psas/lv3.1-avionics/README.md

# lv3.1-avionics
Avionics for the LV3.1 rocket
