psas/lv3.1-avionics/CameraBoard/eagle/CameraBoardRev1.0.jpg

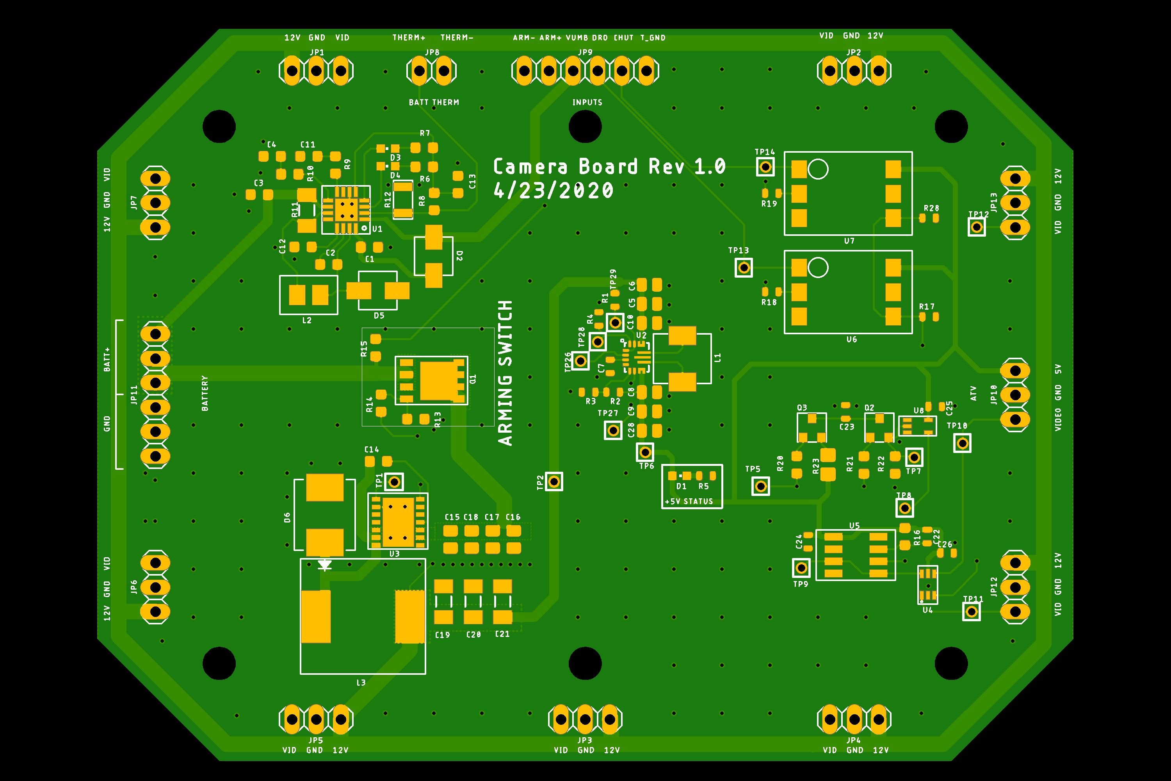
CameraBoard/eagle/CameraBoardRev1.0.jpg
