psas/lv3.1-avionics/CameraBoard/eagle/cameraMasterBoard.DXF

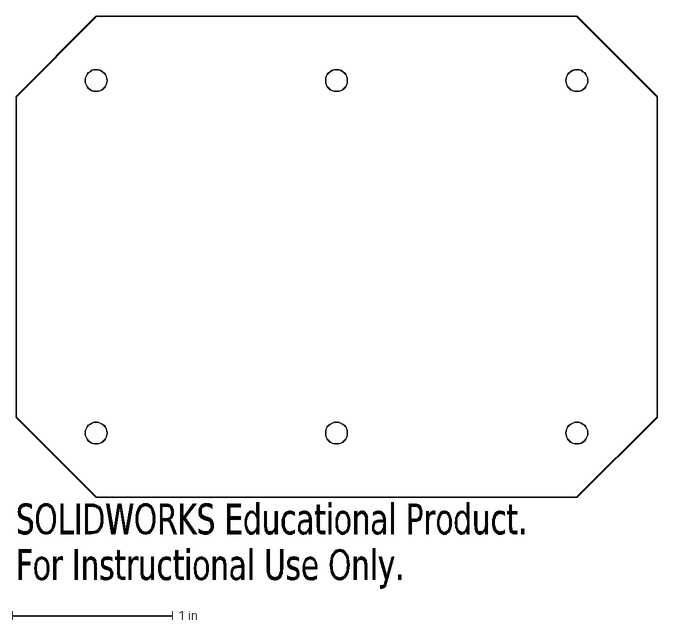
[picture p2: CAD file, 2020-04-24]
CameraBoard/eagle/cameraMasterBoard.DXF
SOLIDWORKS Educational Product.
For Instructional Use Only.
