psas/lv3.1-avionics/CameraBoard/kicad/CameraBoard.kicad_pcb

## KiCad design CameraBoard/kicad/CameraBoard.kicad_pcb (2026-08-20)

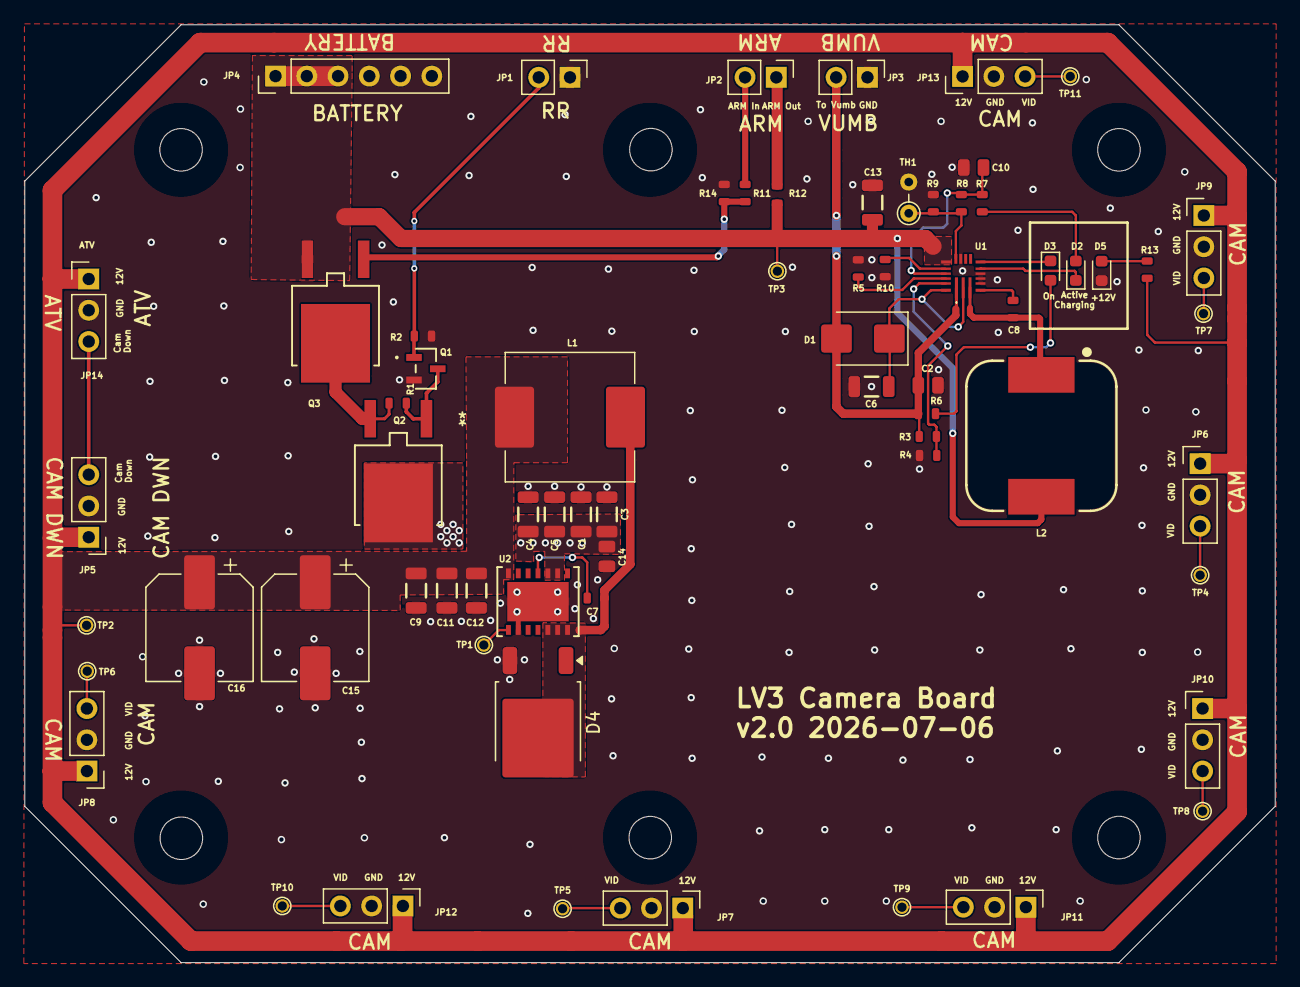
[picture p3: board CameraBoard.kicad_pcb from above]

Board: 2 copper layers, 101.6 x 76.2 mm, 68 parts (0 on the bottom side), 36 nets.

Parts:
C1, C3, C4, C5, C9, C11, C12, C13: 10u; 1206-C
C2, C10, C14: 1u; 0805-C-NOSILK
C6: 2.2u; 1206-C
C7: 10n; 0603-C-NOSILK
C8: 100n; 0603-C-NOSILK
C15, C16: 100u; CP_Elec_8x10.5
D1: B240; D_SMB
D2, D3: AMB; LED_0603_1608Metric
D4: MBRD835; TO-252-2
D5: GRN; LED_0603_1608Metric
JP1, JP2, JP3: PinHeader_1x02_P2.54mm_Vertical
JP4: PINHD-1X6; PinHeader_1x06_P2.54mm_Vertical
JP5, JP6, JP7, JP8, JP9, JP10, JP11, JP12, JP13, JP14: PINHD-1X3; PinHeader_1x03_P2.54mm_Vertical
L1: 22u; L_Vishay_IHLP-4040
L2: 10u; WE-PD_1260
Q1: DMG3404L-7; DMG3404L_DIO
Q2, Q3: AOD4185; TO252_AOS-M
R1, R2, R4, R6, R13: 10k; 0603-C-NOSILK
R3: 133k; 0603-C-NOSILK
R5: 33k; 0603-C-NOSILK
R7: 2k; 0603-C-NOSILK
R8: 2.26k; 0603-C-NOSILK
R9: 6.98k; 0603-C-NOSILK
R10: 38.3k; 0603-C-NOSILK
R11, R12: 1k; 0603-C-NOSILK
R14: 150k; 0603-C-NOSILK
TH1: 10k; R_Axial_DIN0204_L3.6mm_D1.6mm_P2.54mm_Vertical
TP1, TP2, TP3, TP4, TP5, TP6, TP7, TP8, TP9, TP10, TP11: Test-Point; TestPoint-0.75mm-th
U1: MP2659GQ-0000-Z; MP2659GQ0000Z
U2: LM2678SD-ADJ/NOPB; SRC14A

Connections:
+12V: C9.1, C11.1, C12.1, C15.1, C16.1, JP5.1, JP6.1, JP7.1, JP8.1, JP9.1, JP10.1, JP11.1, JP12.1, JP13.1, JP14.1, L1.2, R13.2, TP2.1 (1_1), U2.7 (FB)
/ARM-IN: JP2.2, R11.1
/ARM-OUT: JP2.1, R12.1
/BATT+: C13.1, JP4.1, JP4.2, JP4.3, L2.2, Q3.3 (S), R12.2, TP3.1 (1_1), U1.14 (BATT)
/CAM_DOWN: JP5.3, JP14.3
/VUMB: C2.1, D1.2 (A), JP3.2, R3.2, R6.1, U1.1 (IN)
GND: C1.2, C2.2, C3.2, C4.2, C5.2, C6.1, C9.2, C10.2, C11.2, C12.2, C13.2, C14.2, C15.2, C16.2, D4.3 (A), D5.1 (K), JP1.1, JP3.1, JP4.4, JP4.5, JP4.6, JP5.2, JP6.2, JP7.2, JP8.2, JP9.2, JP10.2, JP11.2, JP12.2, JP13.2, JP14.2, Q1.2 (S), R2.2, R4.1, R5.1, R9.2, R10.2, R14.2, TH1.2, U1.5 (PGND), U1.6 (PGND), U1.7 (PGND), U1.12 (AGND), U2.9 (GND), U2.15 (GND)
unnamed: C6.2, D1.1 (K), U1.2 (PMID), U1.19 (PMID_S)
unnamed: D2.2 (A), R6.2
unnamed: D2.1 (K), U1.9 (~ACOK)
unnamed: D3.2 (A), R7.2
unnamed: D3.1 (K), U1.8 (~STAT)
unnamed: C7.1, D4.2 (K), L1.1, U2.12 (SW), U2.13 (SW), U2.14 (SW)
unnamed: D5.2 (A), R13.1
unnamed: JP1.2, Q1.1 (G), R2.1
unnamed: JP6.3, TP4.1 (1_1)
unnamed: JP7.3, TP5.1 (1_1)
unnamed: JP8.3, TP6.1 (1_1)
unnamed: JP9.3, TP7.1 (1_1)
unnamed: JP10.3, TP8.1 (1_1)
unnamed: JP11.3, TP9.1 (1_1)
unnamed: JP12.3, TP10.1 (1_1)
unnamed: JP13.3, TP11.1 (1_1)
unnamed: Q1.3 (D), Q2.1 (G), R1.2
unnamed: C1.1, C3.1, C4.1, C5.1, C14.1, Q2.2 (D), U2.2 (Vin), U2.3 (Vin)
unnamed: Q3.1 (G), R11.2, R14.1
unnamed: C8.1, U1.4 (BST)
unnamed: R5.2, U1.17 (ILIM)
unnamed: R10.1, U1.15 (ISET)
unnamed: R8.2, R9.1, TH1.1, U1.13 (NTC)
unnamed: C8.2, L2.1, U1.3 (SW)
unnamed: R3.1, R4.2, U1.18 (VDPM)
unnamed: C7.2, U2.4 (BOOST)
unnamed: TP1.1 (1_1), U2.8 (ON)
VBATT: Q2.3 (S), Q3.2 (D), R1.1
VCC: C10.1, R7.1, R8.1, U1.16 (VCC)
