psas/lv3.1-avionics/CameraBoard/eagle/CameraBoard.brd

## EAGLE design CameraBoard/eagle/CameraBoard.brd (2020-07-20)

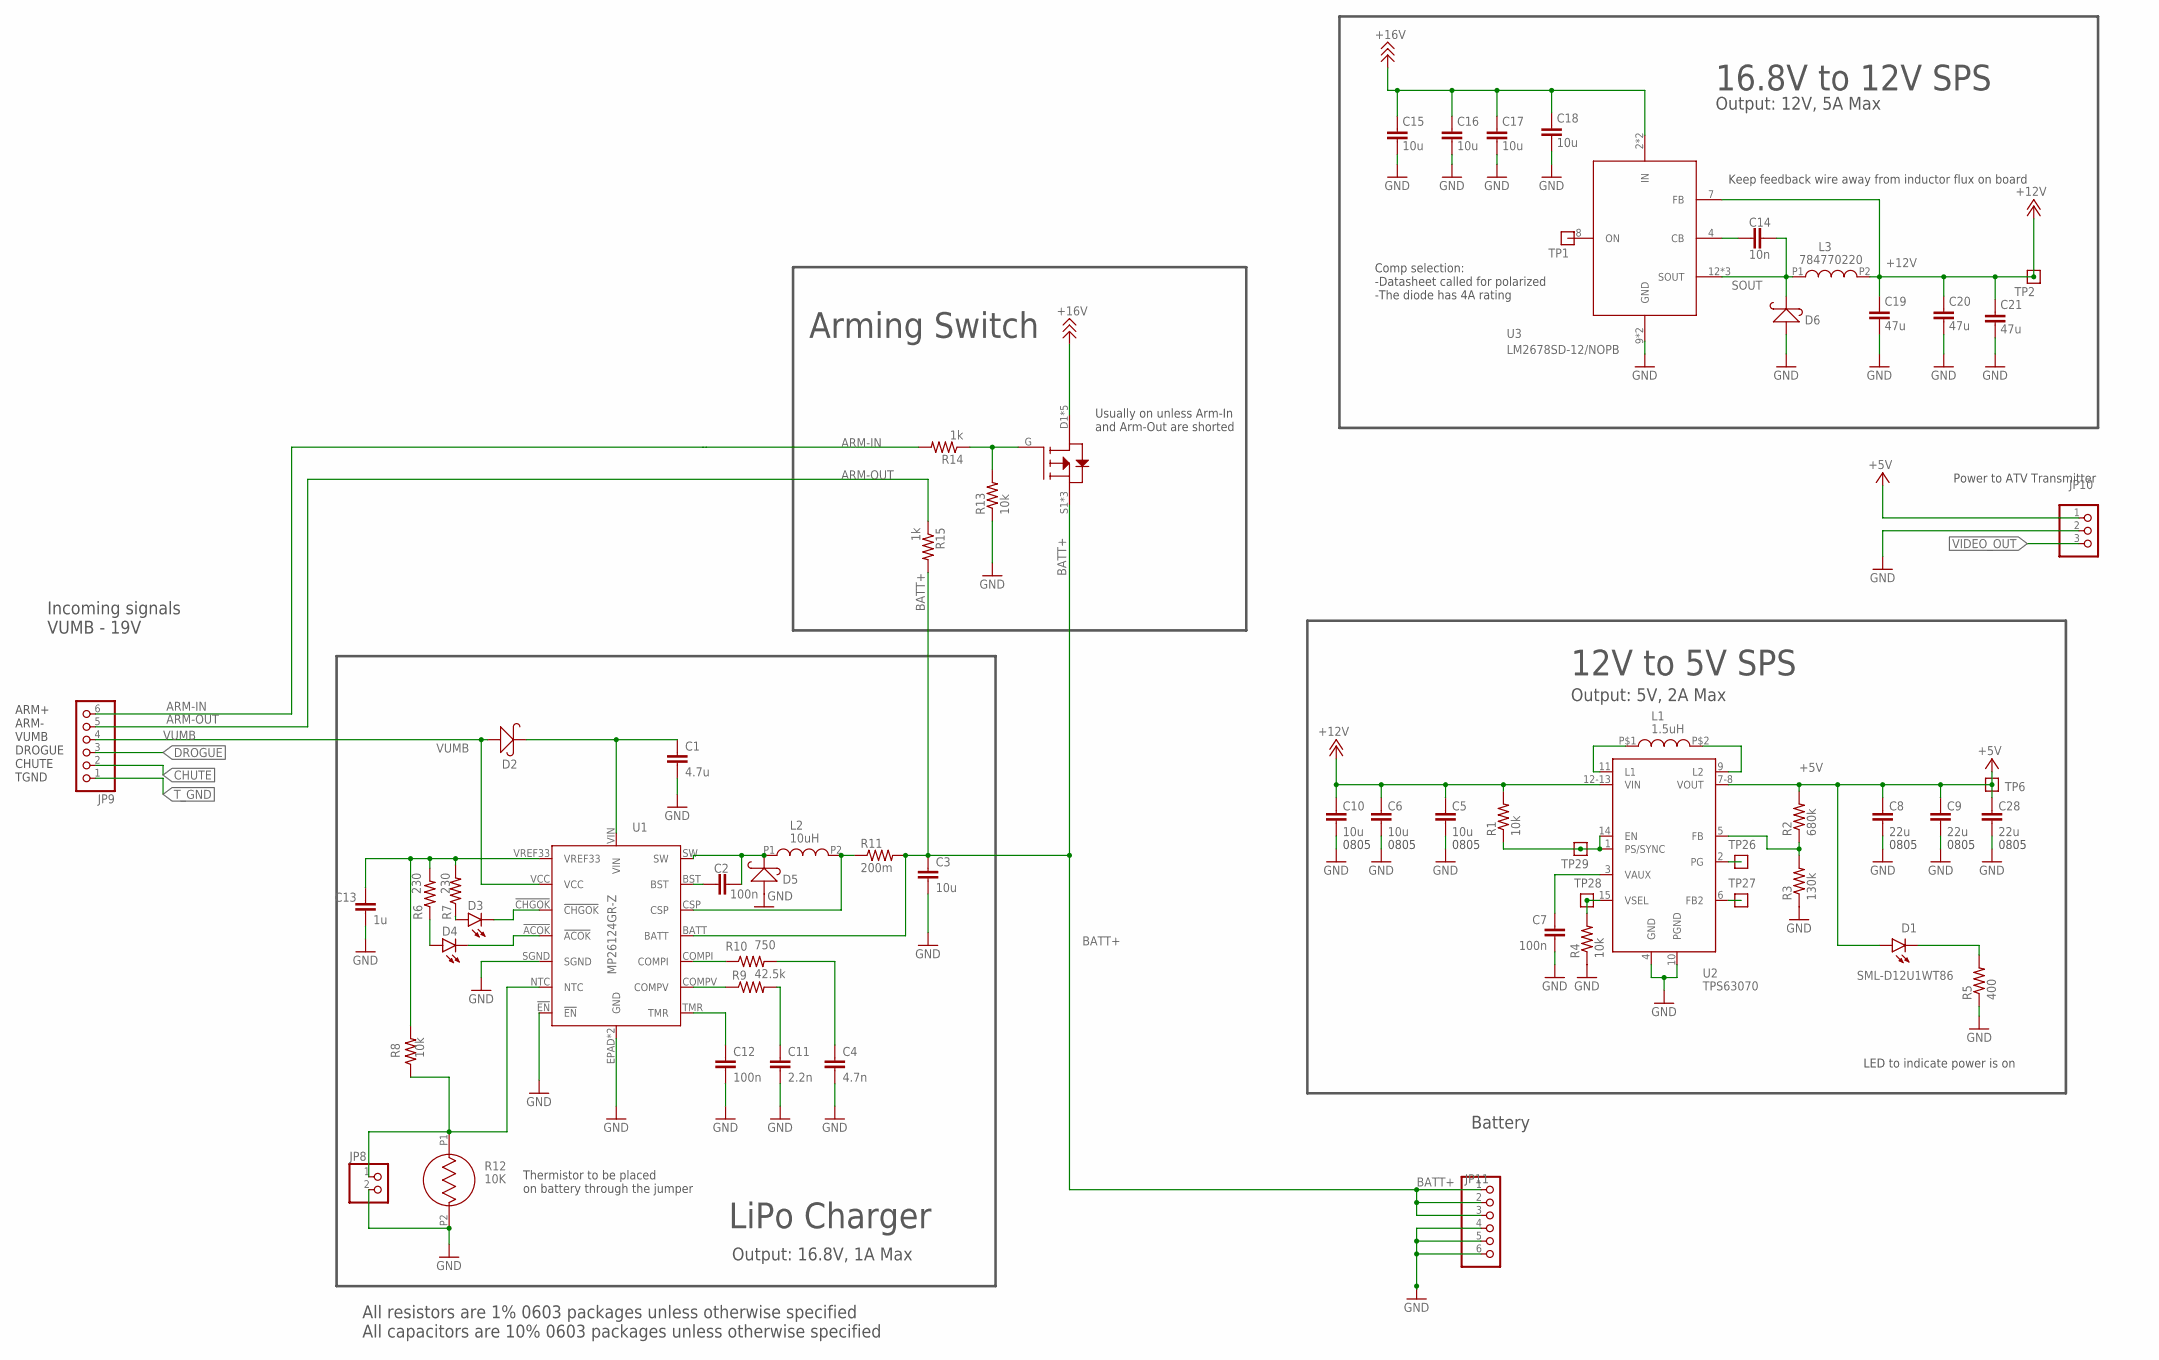
[picture p4: schematic CameraBoard.sch, sheet 1, Power Management]

Parts:
C1: 4.7u; .0603-A-NOSILK
C2, C12: 100n; .0603-A-NOSILK
C3: 10u; .0603-A-NOSILK
C4: 4.7n; .0603-A-NOSILK
C5: 10u; .0805-C-NOSILK; MPN CL05B104KO5NNNC
C6, C10: 10u; .0805-C-NOSILK
C7: 100n; .0603-C-NOSILK; MPN CL05B104KO5NNNC
C8: 22u; .0805-C-NOSILK; MPN CL05B104KO5NNNC
C9, C28: 22u; .0805-C-NOSILK
C11: 2.2n; .0603-A-NOSILK
C13: 1u; .0603-A-NOSILK
C14: 10n; .0603-A-NOSILK
C15, C16, C17, C18: 10u; .0805-B-NOSILK
C19, C20, C21: 47u; 1206-A
D1, D3, D4: SML-D12U1WT86; CHIPLED_0603; MPN SML-D12M1WT86
D2, D5: S2MA-13-F
D6: D_MBRS340T3G; SMC
JP8: PINHD-1X2; 1X02
JP9, JP11: PINHD-1X6; 1X06
JP10: PINHD-1X3; 1X03
L1: 1.5uH; IHLP2020CZER1R5M11
L2: 10uH; 1239AS-H-100M=P2
L3: 784770220
Q1: SI7465DP-T1-E3; SI7465DP-T1-E3CT-ND
R1, R4: 10k; .0603-C-NOSILK; MPN RC1005F6653CS
R2: 680k; .0603-C-NOSILK; MPN RC1005F6653CS
R3: 130k; .0603-C-NOSILK; MPN RC1005F6653CS
R5: 400; .0603-C-NOSILK; MPN RC1005F6653CS
R6, R7: 230; .0603-A-NOSILK
R8, R13: 10k; .0603-A-NOSILK
R9: 42.5k; .0603-A-NOSILK
R10: 750; .0603-A-NOSILK
R11: 200m; 1206-A
R12: 10K; NHQ103B375T10
R14, R15: 1k; .0603-A-NOSILK
TP1, TP2, TP6, TP26, TP27, TP28, TP29: TEST-POINT; 2MM-TEST-POINT
U1: MP26124GR-Z
U2: TPS63070; TPS63070X; MPN TPS63070RNMR
U3: LM2678SD-12/NOPB

Connections:
+5V: C8.1, C9.1, C28.1, D1.A, JP10.1, R2.2, TP6.1, U2.7-8 (VOUT); also elsewhere on the board
+12V: C5.1, C6.1, C10.1, C19.1, C20.1, C21.1, L3.P2, R1.2, TP2.1, U2.12-13 (VIN), U3.7 (FB); also elsewhere on the board
+16V: C15.1, C16.1, C17.1, C18.1, Q1.D1 (D), Q1.D2 (D), Q1.D3 (D), Q1.D4 (D), Q1.DPAD (D), U3.2 (IN), U3.3 (IN)
ARM-IN: JP9.6, R14.2
ARM-OUT: JP9.5, R15.1
BATT+: C3.1, JP11.1, JP11.2, JP11.3, Q1.S1 (S), Q1.S2 (S), Q1.S3 (S), R11.2, R15.2, U1.BATT
CHUTE: JP9.2; also elsewhere on the board
DROGUE: JP9.3; also elsewhere on the board
GND: C1.2, C3.2, C4.2, C5.2, C6.2, C7.2, C8.2, C9.2, C10.2, C11.2, C12.2, C13.2, C15.2, C16.2, C17.2, C18.2, C19.2, C20.2, C21.2, C28.2, D5.ANODE (+), D6.2 (+), JP8.2, JP10.2, JP11.4, JP11.5, JP11.6, R3.1, R4.1, R5.1, R12.P2, R13.1, U1.!EN, U1.EPAD (GND), U1.GND, U1.SGND, U2.4 (GND), U2.10 (PGND), U3.9 (GND), U3.DAP (GND); also elsewhere on the board
unnamed: D1.C, R5.2
unnamed: C1.1, D2.CATHODE (-), U1.VIN
unnamed: Q1.G, R13.2, R14.1
unnamed: C13.1, R6.2, R7.2, R8.2, U1.VREF33
unnamed: D4.A, R6.1
unnamed: D3.A, R7.1
unnamed: D3.C, U1.!CHGOK
unnamed: D4.C, U1.!ACOK
unnamed: C12.1, U1.TMR
unnamed: JP8.1, R8.1, R12.P1, U1.NTC
unnamed: R9.1, U1.COMPV
unnamed: C11.1, R9.2
unnamed: R10.1, U1.COMPI
unnamed: C4.1, R10.2
unnamed: C2.1, D5.CATHODE (-), L2.P1, U1.SW
unnamed: C2.2, U1.BST
unnamed: L2.P2, R11.1, U1.CSP
unnamed: TP1.1, U3.8 (ON)
unnamed: C14.2, U3.4 (CB)
SOUT: C14.1, D6.1 (-), L3.P1, U3.12 (SOUT), U3.13 (SOUT), U3.14 (SOUT)
TPS-EN: R1.1, TP29.1, U2.1 (PS/SYNC), U2.14 (EN)
TPS-FB: R2.1, R3.2, U2.5 (FB)
TPS-FB2: TP27.1, U2.6 (FB2)
TPS-L1: L1.P$1, U2.11 (L1)
TPS-L2: L1.P$2, U2.9 (L2)
TPS-PG: TP26.1, U2.2 (PG)
TPS-VAUX: C7.1, U2.3 (VAUX)
TPS-VSEL: R4.2, TP28.1, U2.15 (VSEL)
T_GND: JP9.1; also elsewhere on the board
VIDEO_OUT: JP10.3; also elsewhere on the board
VUMB: D2.ANODE (+), JP9.4, U1.VCC

Notes on the sheet:
Incoming signals VUMB - 19V
Battery
0805
LED to indicate power is on
ARM+ ARM- VUMB DROGUE CHUTE TGND
Usually on unless Arm-In and Arm-Out are shorted
12V to 5V SPS
LiPo Charger
16.8V to 12V SPS
Arming Switch
Power to ATV Transmitter
Keep feedback wire away from inductor flux on board
Comp selection: -Datasheet called for polarized -The diode has 4A rating
Thermistor to be placed on battery through the jumper
All resistors are 1% 0603 packages unless otherwise specified All capacitors are 10% 0603 packages unless otherwise specified
Output: 12V, 5A Max
Output: 5V, 2A Max
Output: 16.8V, 1A Max

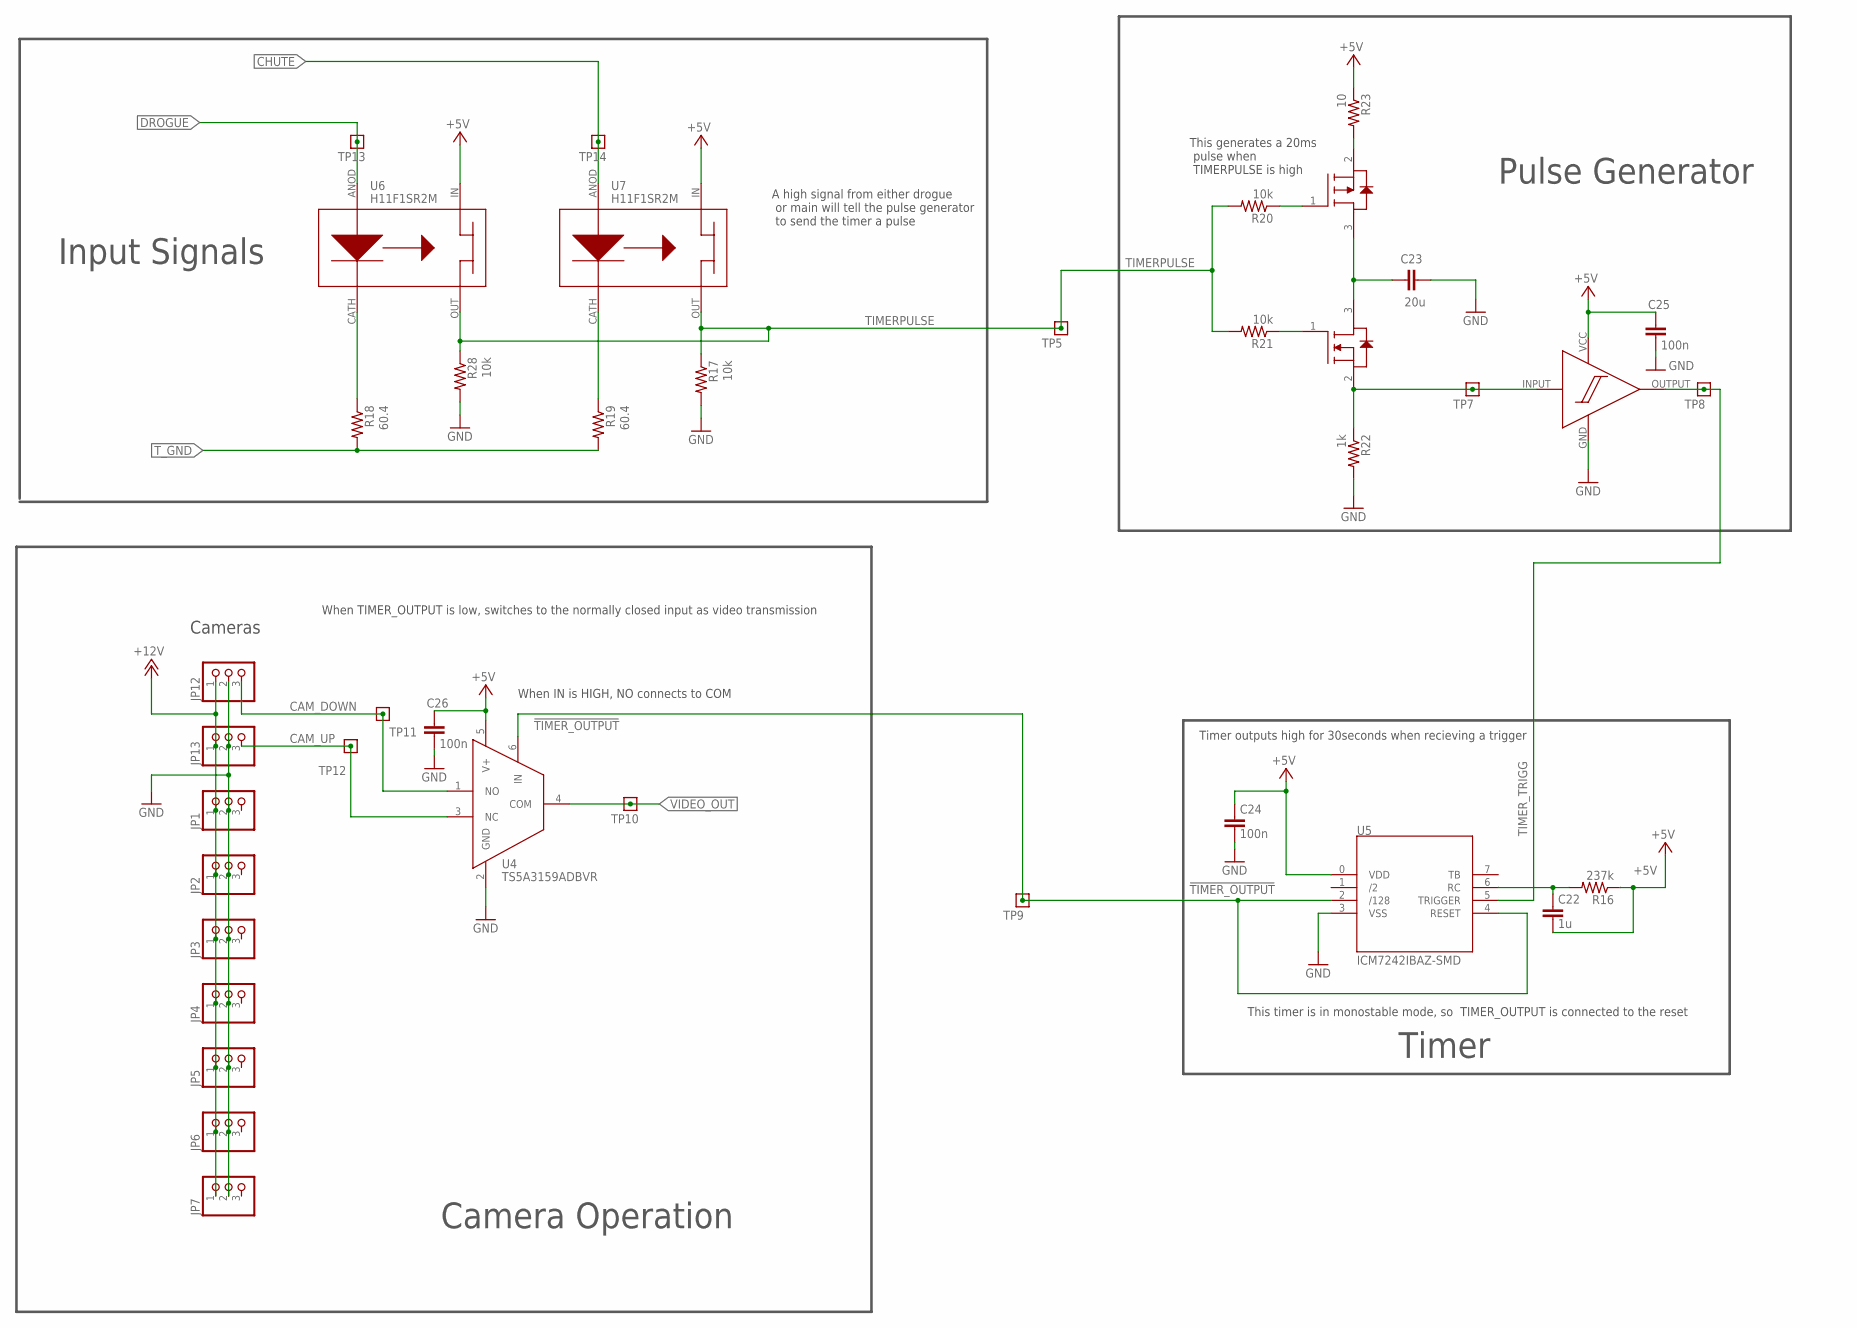
[picture p5: schematic CameraBoard.sch, sheet 2, Camera Control]

Parts:
C22: 1u; .0603-C-NOSILK
C23: 20u; .0603-C-NOSILK
C24, C25, C26: 100n; .0603-C-NOSILK
JP1, JP2, JP3, JP4, JP5, JP6, JP7, JP12, JP13: PINHD-1X3; 1X03
Q2: BVSS123LT1G
Q3: BSS84
R16: 237k; .0603-A-NOSILK
R17, R28: 10k; .0603-C-NOSILK
R18, R19: 60.4; .0603-C-NOSILK
R20, R21: 10k; .0603-A-NOSILK
R22: 1k; .0603-A-NOSILK
R23: 10; .0805-A-NOSILK
TP5, TP7, TP8, TP9, TP10, TP11, TP12, TP13, TP14: TEST-POINT; 2MM-TEST-POINT
U4: TS5A3159ADBVR
U5: ICM7242IBAZ-SMD
U6, U7: H11F1SR2M; MPN H11F1SR2M
U8: SN74LVC1G17DCKR

Connections:
!TIMER_OUTPUT: TP9.1, U4.6 (IN), U5.2 (/128), U5.4 (RESET)
+5V: C22.2, C24.1, C25.2, C26.2, R16.1, R23.1, U4.5 (V+), U5.0 (VDD), U6.IN, U7.IN, U8.VCC; also elsewhere on the board
+12V: JP1.1, JP2.1, JP3.1, JP4.1, JP5.1, JP6.1, JP7.1, JP12.1, JP13.1; also elsewhere on the board
CAM_DOWN: JP12.3, TP11.1, U4.1 (NO)
CAM_UP: JP13.3, TP12.1, U4.3 (NC)
CHUTE: TP14.1, U7.ANOD; also elsewhere on the board
DROGUE: TP13.1, U6.ANOD; also elsewhere on the board
GND: C23.2, C24.2, C25.1, C26.1, JP1.2, JP2.2, JP3.2, JP4.2, JP5.2, JP6.2, JP7.2, JP12.2, JP13.2, R17.2, R22.2, R28.2, U4.2 (GND), U5.3 (VSS), U8.GND; also elsewhere on the board
unnamed: R18.1, U6.CATH (CAT)
unnamed: R19.1, U7.CATH (CAT)
unnamed: C22.1, R16.2, U5.6 (RC)
unnamed: C23.1, Q2.3 (D), Q3.3 (D)
unnamed: Q3.2 (S), R23.2
unnamed: Q3.1 (G), R20.1
unnamed: Q2.1 (G), R21.1
SCHMITTIN: Q2.2 (S), R22.1, TP7.1, U8.INPUT (A)
TIMERPULSE: R17.1, R20.2, R21.2, R28.1, TP5.1, U6.OUT, U7.OUT
TIMER_TRIGG: TP8.1, U5.5 (TRIGGER), U8.OUTPUT (Y)
T_GND: R18.2, R19.2; also elsewhere on the board
VIDEO_OUT: TP10.1, U4.4 (COM); also elsewhere on the board

Notes on the sheet:
Cameras
Camera Operation
This timer is in monostable mode, so TIMER_OUTPUT is connected to the reset
A high signal from either drogue or main will tell the pulse generator to send the timer a pulse
Input Signals
Timer
Pulse Generator
This generates a 20ms pulse when TIMERPULSE is high
When TIMER_OUTPUT is low, switches to the normally closed input as video transmission
When IN is HIGH, NO connects to COM
Timer outputs high for 30seconds when recieving a trigger

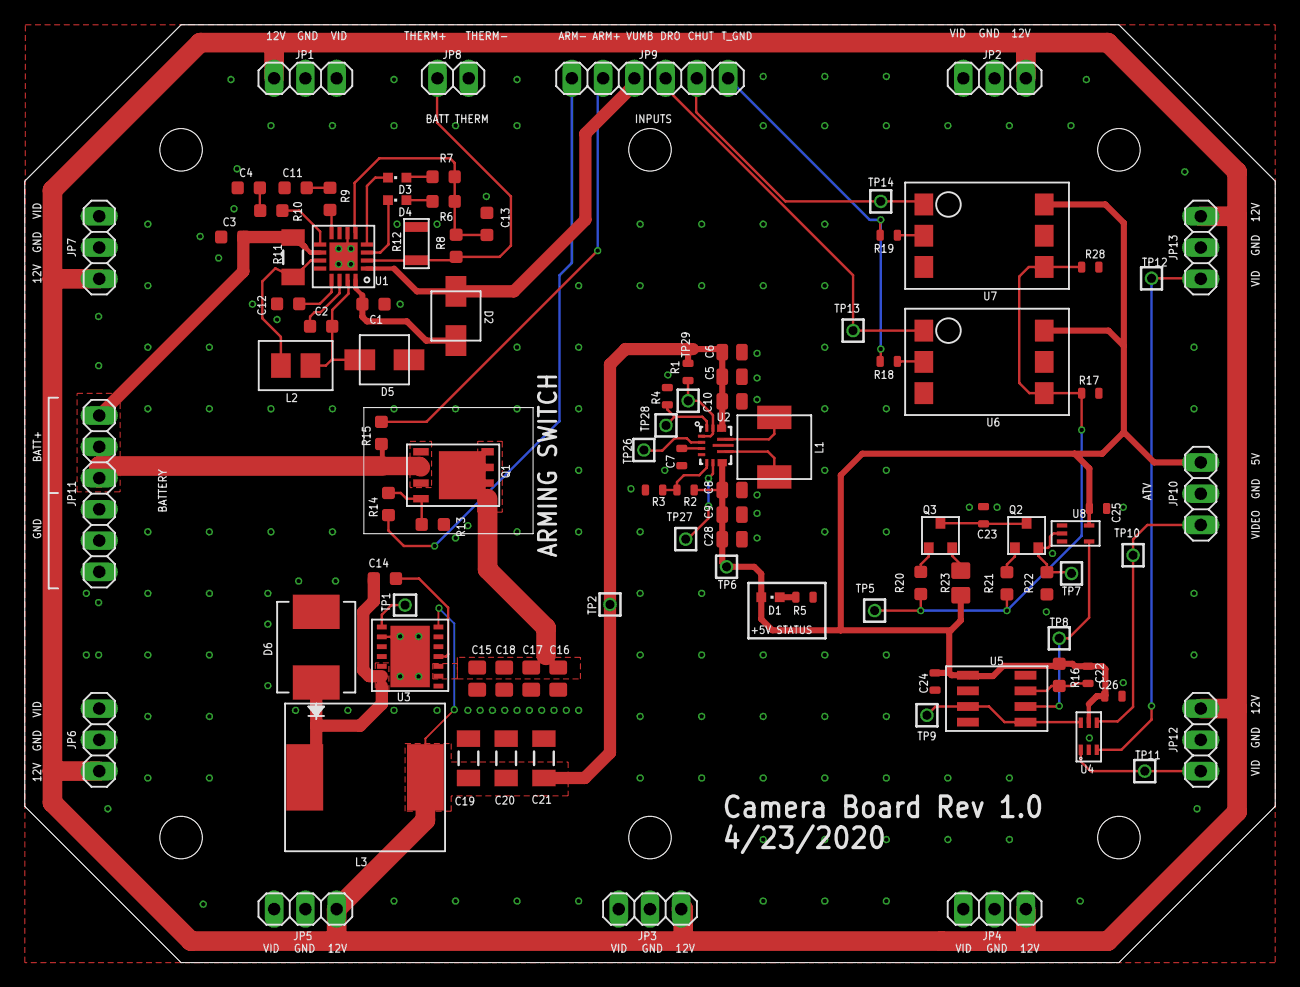
[picture p6: board CameraBoard.brd from above]

Board: 2 copper layers, 101.6 x 76.2 mm, 100 parts (0 on the bottom side), 53 nets.
