psas/lv3.1-avionics/(commit log)

2020-04-22 adding first design review notes
    [CameraBoard.sch]
2020-04-23 power schematic for board
    [CameraBoard.sch]
2020-04-23 first draft of schematic complete
    [CameraBoard.sch]
2020-04-24 layed out board before routing
    [CameraBoard.brd, CameraBoard.sch, cameraMasterBoard.DXF]
2020-04-24 finished board layout before routing
    [CameraBoard.brd, CameraBoard.sch]
2020-04-24 completed routing of board rev 1.0
    [CameraBoard.brd, CameraBoard.sch]
2020-04-28 new image
    [CameraBoard.brd, CameraBoard.sch]
2020-04-29 added all the suggestions from first design review
    [CameraBoard.brd, CameraBoard.sch]
2020-04-29 moved text around, and added new .jpg
    [CameraBoard.brd]
2020-07-07 added BOM
    [CameraBoard BOM.xlsx, CameraBoard.brd, CameraBoard.sch]
2020-07-20 Minor erc and drc cleanup, ground plane cleanup, nothing major.
    [CameraBoard.brd, CameraBoard.sch]
2020-10-05 Added molex connectors
    [CameraBoard BOM.xlsx]
2023-08-20 Added KiCAD 7 import of CameraBoard. Updated .gitignore file, too.
    [CameraBoard.kicad_pcb, CameraBoard.kicad_sch, Camera_Control.kicad_sch, Power_Management.kicad_sch]
2025-06-24 Updated KiCAD EAGLE import to latest KiCAD 9.0.2.
    [CameraBoard.kicad_pcb, CameraBoard.kicad_sch, CameraBoard_1.kicad_sch, CameraBoard_2.kicad_sch, Camera_Control.kicad_sch, Power_Management.kicad_sch]
2025-07-02 Added wiring diagram; avionics module complete!
    [WiringDiagram.kicad_pcb, WiringDiagram.kicad_sch]
2025-07-02 Added connector notes
    [WiringDiagram.kicad_sch]
2025-07-02 Add note on extra wire length
    [WiringDiagram.kicad_sch]
2025-07-16 Added umbilical ring connections
    [WiringDiagram.kicad_sch]
2025-07-16 Minor polishing
    [WiringDiagram.kicad_sch]
2025-07-30 Added another connector on umbilical cord
    [WiringDiagram.kicad_sch]
2025-08-02 Changed pulldown to 150k and added note about flipped connector.
    [CameraBoard.kicad_pcb, CameraBoard_1.kicad_sch]
2025-08-03 Cleaned up second page - fixed optoisolator symbols, added notes about levels and times, and cleaned up alot. Put in notes about mod wires.
    [CameraBoard.kicad_pcb, CameraBoard_1.kicad_sch, CameraBoard_2.kicad_sch]
2025-08-04 Make schematic better, mostly cleaning up EAGLE import errors
    [CameraBoard_1.kicad_sch, CameraBoard_2.kicad_sch]
2026-01-28 Added umbilical cable adapter with labels
    [WiringDiagram.kicad_sch]
2026-03-12 Minor updates to PCB
    [CameraBoard.kicad_pcb, CameraBoard_2.kicad_sch]
2026-04-26 replaced the timer logic for a d flip flop
    [CameraBoard.kicad_sch, CameraBoard_1.kicad_sch, CameraBoard_2.kicad_sch]
2026-07-09 changes to lv3.2 camera board
    [CameraBoard.kicad_pcb, CameraBoard.kicad_sch, CameraBoard_1.kicad_sch, CameraBoard_2.kicad_sch]
2026-07-12 Minor updates to schematic
    Removed connectors
    Changed SPS layout
    Added and removed LEDs
    Edited labels
    Fixed IC application
    [CameraBoard.kicad_sch]
2026-07-13 Schematic Clean-up
    Straightened up text, symbols, etc.
    [CameraBoard.kicad_sch]
2026-07-23 PCB made from new schematic
    Made the PCB. There are a few weird errors.
    [CameraBoard.kicad_pcb, CameraBoard.kicad_sch]
2026-07-25 Updates to PCB
    Track width changes
    Fixed silkscreens
    changed ground zone settings
    Added IC Batt zone
    Dropped test points for cams
    [CameraBoard.kicad_pcb, CameraBoard.kicad_sch]
2026-07-25 Small update to PCB
    Fixed some unsnapped traces
    [CameraBoard.kicad_pcb]
2026-08-01 Small updates to PCB
    -Made text the same size
    -Changed U1 symbol
    -Added zones
    -Moved connectors to more convenient location
    -Moved leds together
    [CameraBoard.kicad_pcb, CameraBoard.kicad_sch]
2026-08-02 Small Updates to PCB
    -Fixed zone issue
    [CameraBoard BOM.xlsx, CameraBoard.kicad_pcb, CameraBoard.kicad_sch]
2026-08-02 Small BOM changes
    [CameraBoard.kicad_sch]
2026-08-03 Updates to BOM and Footprints
    -Inductor and thermistor had wrong footprints
    -Had to change layout and reroute traces for footprints
    -Filled out BOM from schematic
    [CameraBoard.kicad_pcb, CameraBoard.kicad_sch]
2026-08-05 Revert "Merge branch 'master' of github.com:psas/lv3.1-avionics"
    This reverts commit e8b3300ae824ca3338ac8ec8f922a1d509083487, reversing
    changes made to 8f716272e32ab4533c36fe5f3d4033526be42e02.
    [CameraBoard.kicad_sch]
2026-08-06 Small Updates to PCB
    - Increased battery trace width
    - Created zone for 12V supply
    - Moved led resistor outside box
    - Rearranged mosfets and capacitors to look nicer
    [CameraBoard.kicad_pcb, CameraBoard.kicad_sch]
2026-08-07 Minor layout changes
    [CameraBoard.kicad_pcb]
2026-08-19 Schematic and PCB Changes
    -Added symbols and footprints to library
    -Changed a couple mosfets and the thermistor for better fits
    -Added more description to connectors
    -Added power flags
    -Edited IC symbols to match datasheets
    -Made sure all components had values showing
    -Added descriptive names to connectors on PCB
    -Rearranged PCB after switching out some components footprints
    [CameraBoard.kicad_pcb, CameraBoard.kicad_sch]
2026-08-20 Small PCB Updates
    -Added more ground vias
    -Moved capacitor closer to IC
    -Moved TP3 closer to track
    [CameraBoard.kicad_pcb]
2026-08-20 Description Fix
    Changed "3.3V" to "5V"
    [CameraBoard.kicad_sch]
2026-08-20 Camerca board v2.0 off to fab
    Pretty-ified schematic by moving things around and redoing the switching supply symbol. Moved labels around, made them all 1.27 mm.
    Fixed BOM by collapsing Rs and Cs together, and brought them up to speed with OReSat shared BOM list. Added tons more capacitance
    to the SPS because of the datasheets claiming it was important. Moved RocketReady connector to board edge, like other connectors.
    [CameraBoard.kicad_pcb, CameraBoard.kicad_sch]
2026-09-20 Updated wiring diagram for upcoming LV3.1 Launch 15 flight
    [WiringDiagram.kicad_sch]
2026-09-23 Add alphabetical connector and numerical wire labels
    [WiringDiagram.kicad_sch]
2026-09-23 Fix double connector label
    [WiringDiagram.kicad_sch]
2026-09-23 Move UMB Bus Connection through the avionics module side
    [WiringDiagram.kicad_sch]
2026-09-23 Fix number double ups
    [WiringDiagram.kicad_sch]
